toripoyo/AnalogMixer/Readme.md

# About

3Ch Analog Mixer with bluetooth in/out.

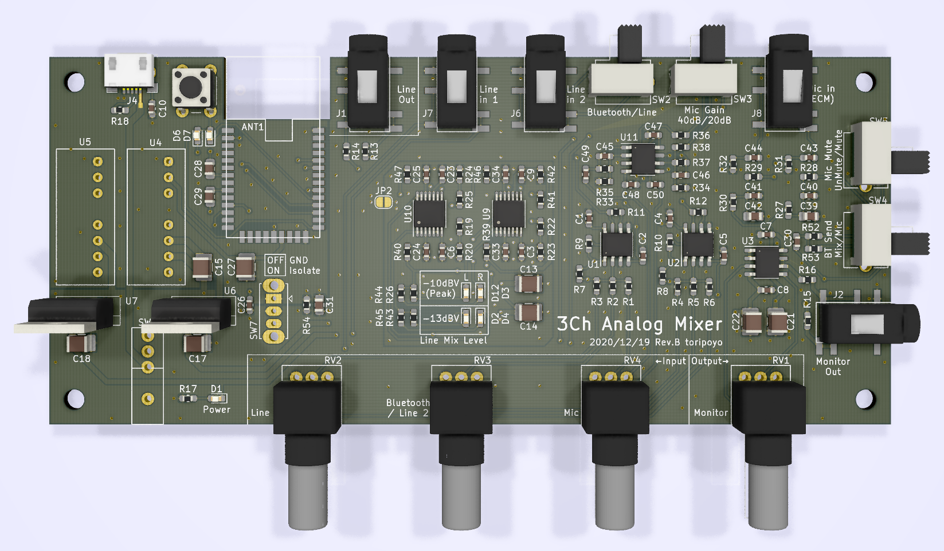
[picture p1: Board.png]
Board


## Input

- Line in 1  
- Line in 2 / Bluetooth in (Selectable)  
- Mic in  

## Output

- Monitor out (headphone)
- Line out
- Bluetooth out (Mix/Mic Selectable)

## Power

- Micro USB

## Other

- Peak warning LED (-10dBV)
