toripoyo/AnalogMixer/Mixer.pdf

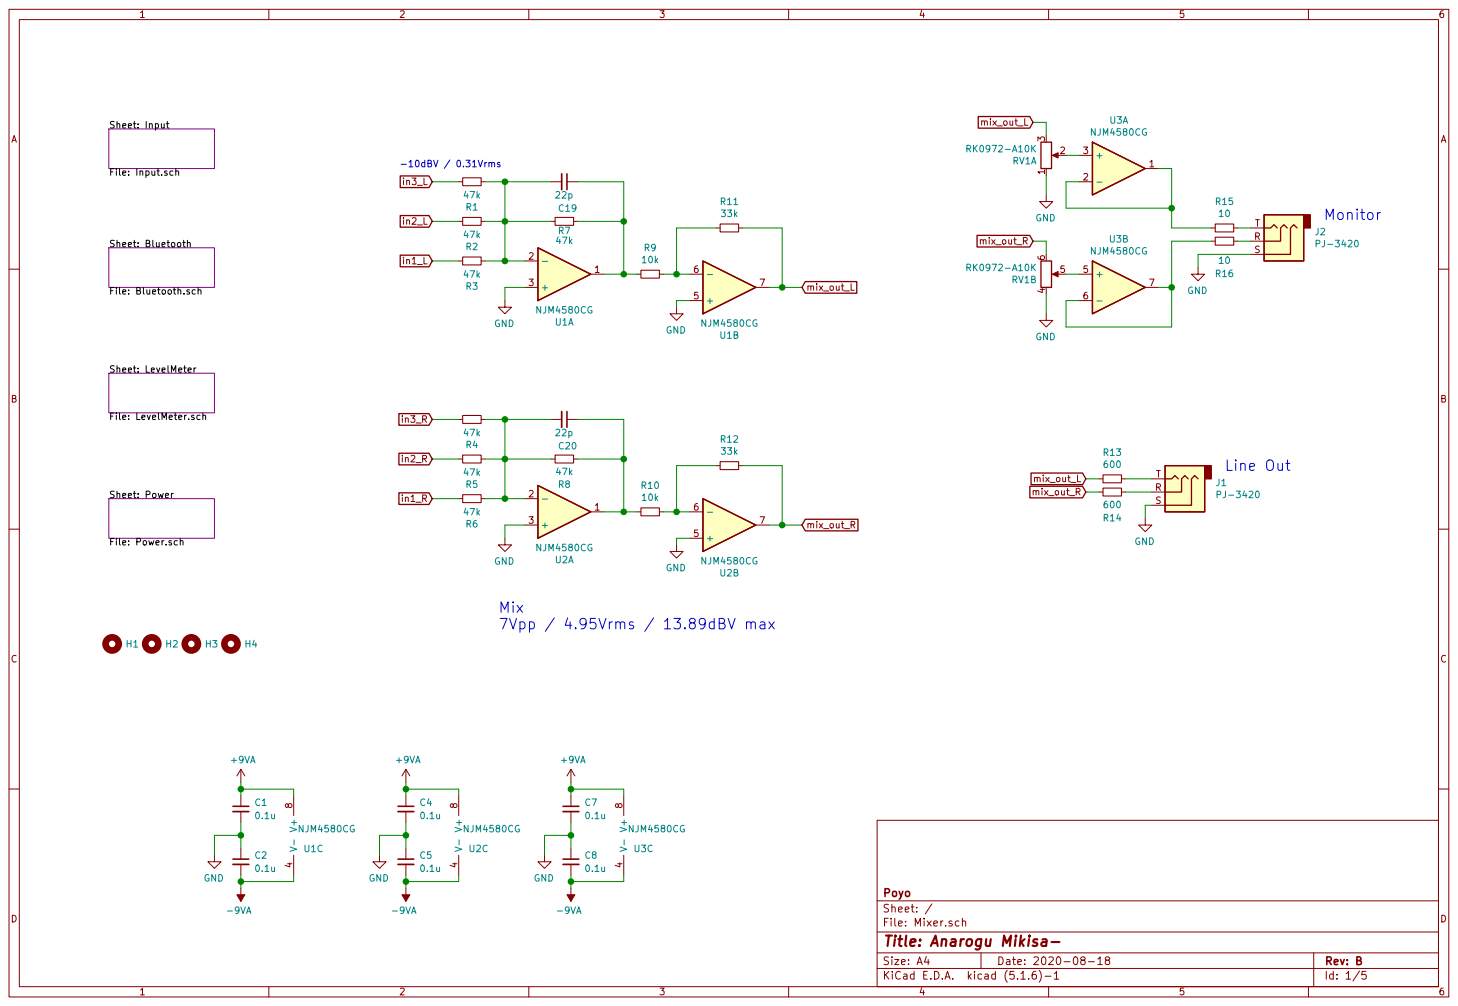
[picture p2: page 1]

Sheet: Power File: Power.sch Sheet: LevelMeter File: LevelMeter.sch Sheet: Bluetooth File: Bluetooth.sch Sheet: Input

Id: 1/5 Title: Anarogu Mikisa- File: Mixer.sch Sheet: / Poyo

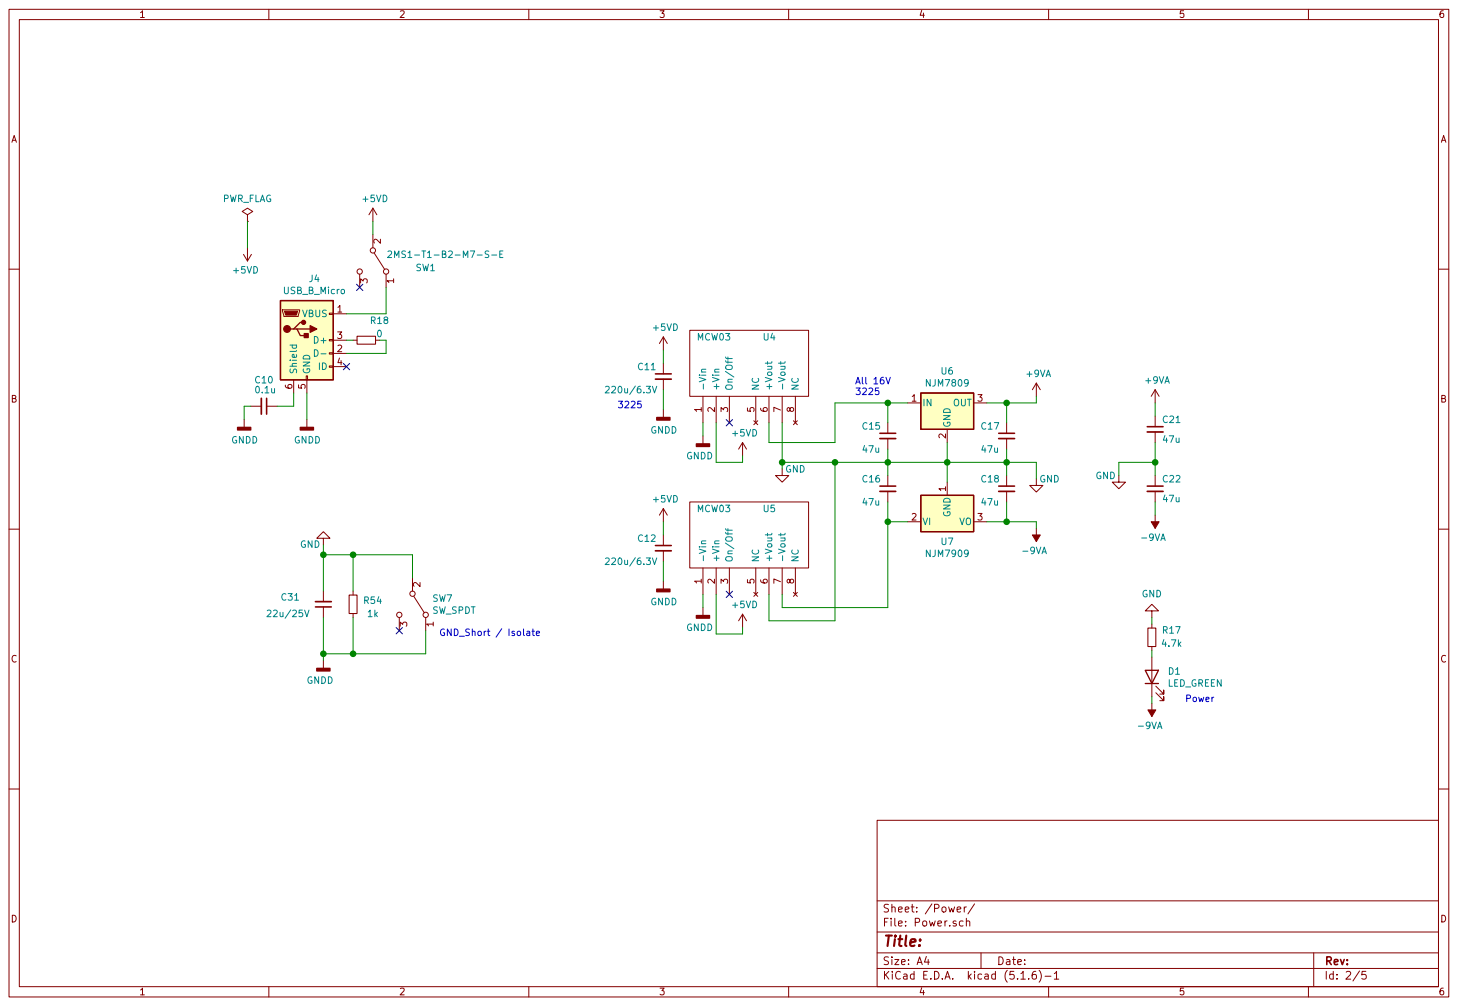
[picture p3: page 2]

Id: 2/5 Title: File: Power.sch Sheet: /Power/

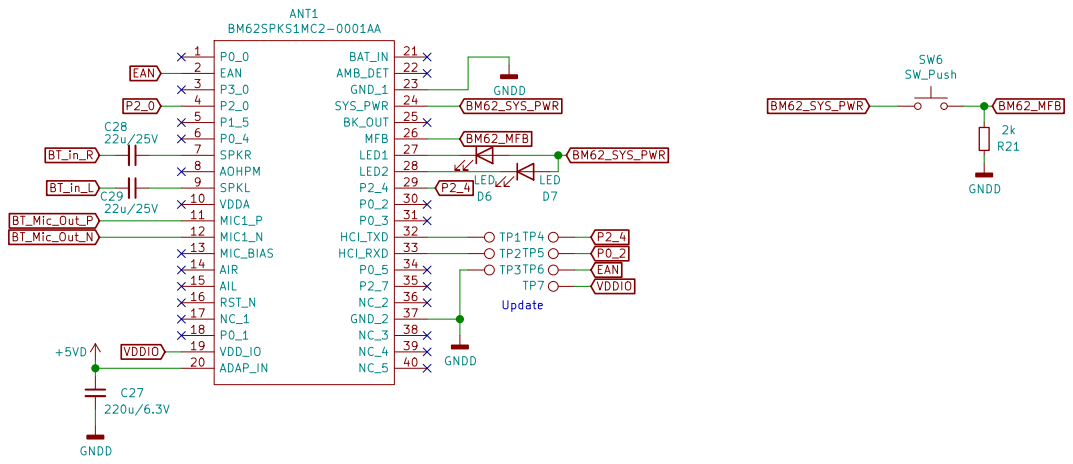
[picture p4: page 3]

Id: 3/5 Title: File: Bluetooth.sch Sheet: /Bluetooth/

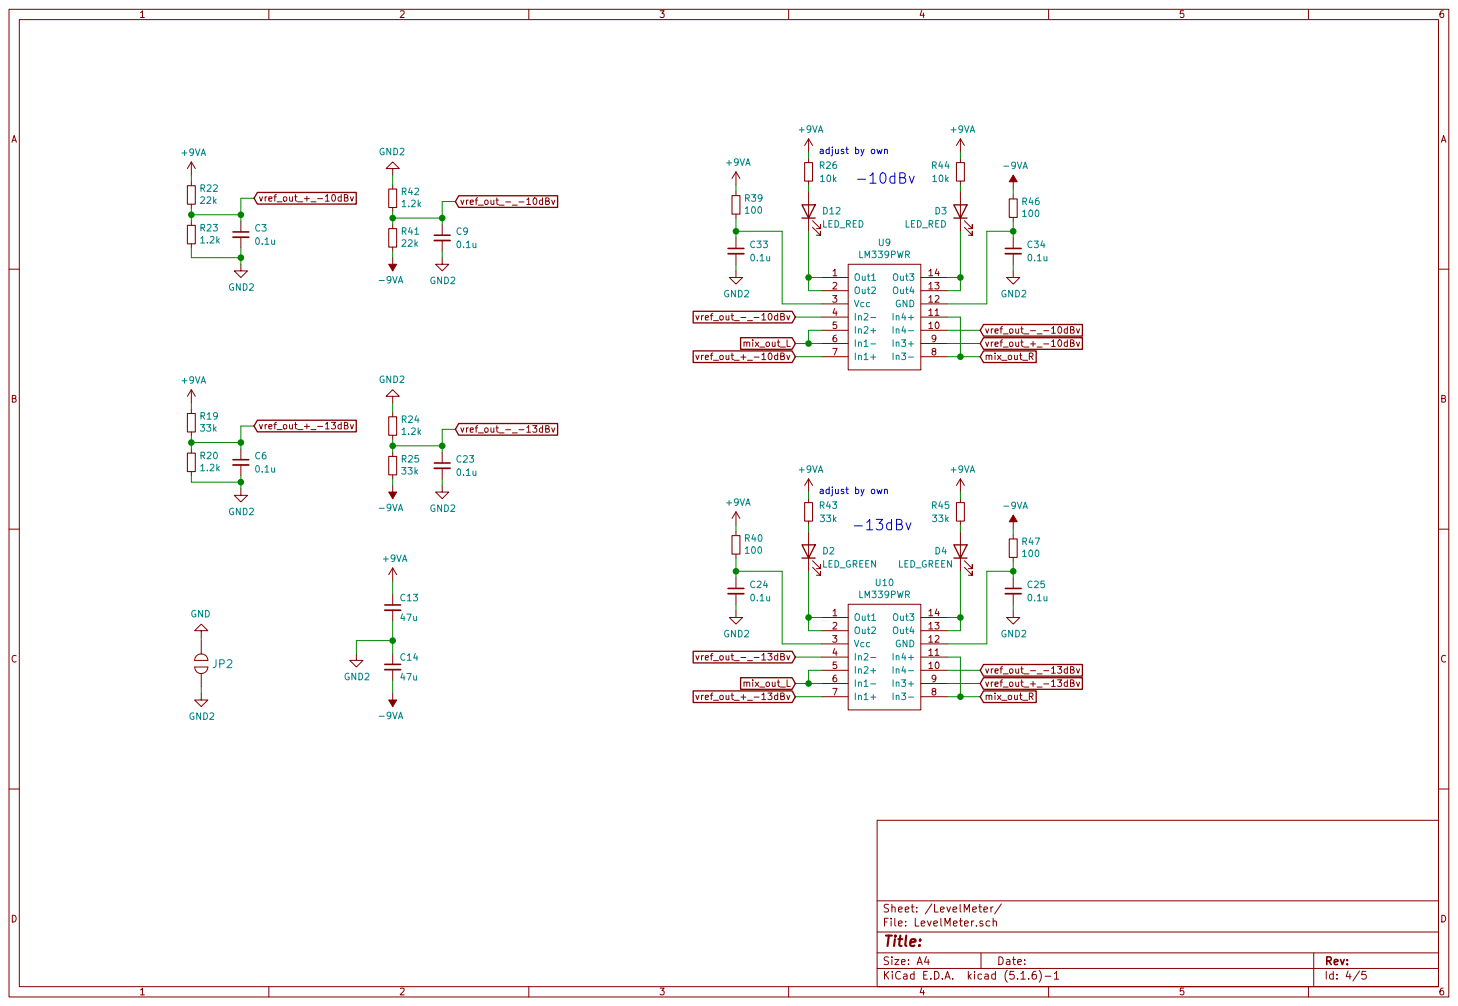
[picture p5: page 4]

Id: 4/5 Title: File: LevelMeter.sch Sheet: /LevelMeter/

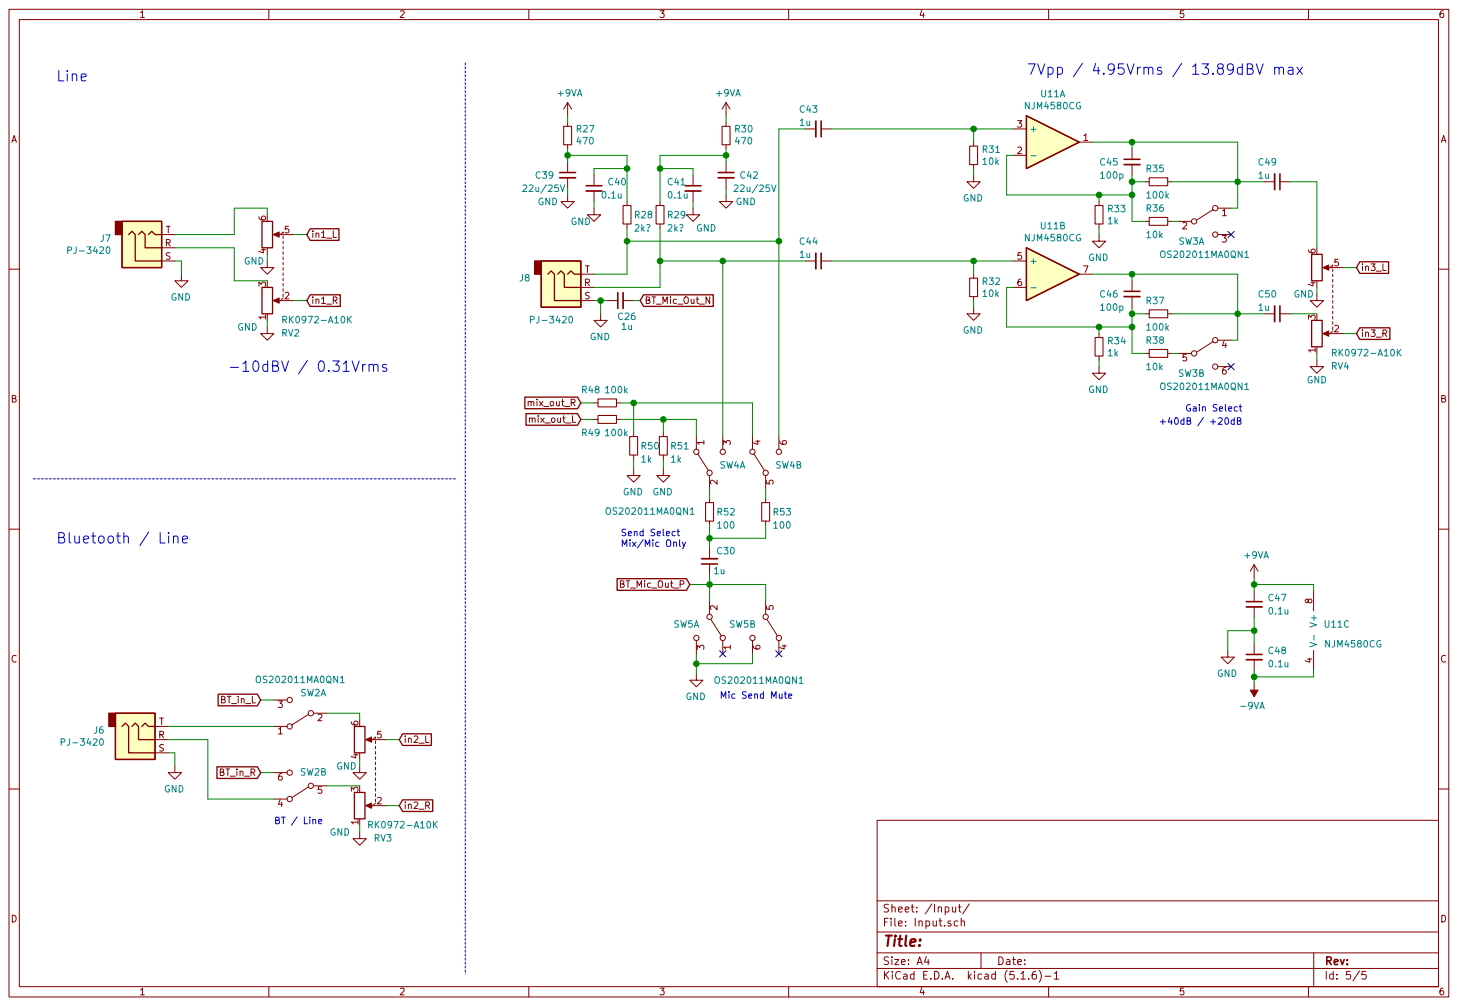
[picture p6: page 5]
