toripoyo/AnalogMixer/Mixer.kicad_pcb

## KiCad design Mixer.kicad_pcb (2020-12-19)

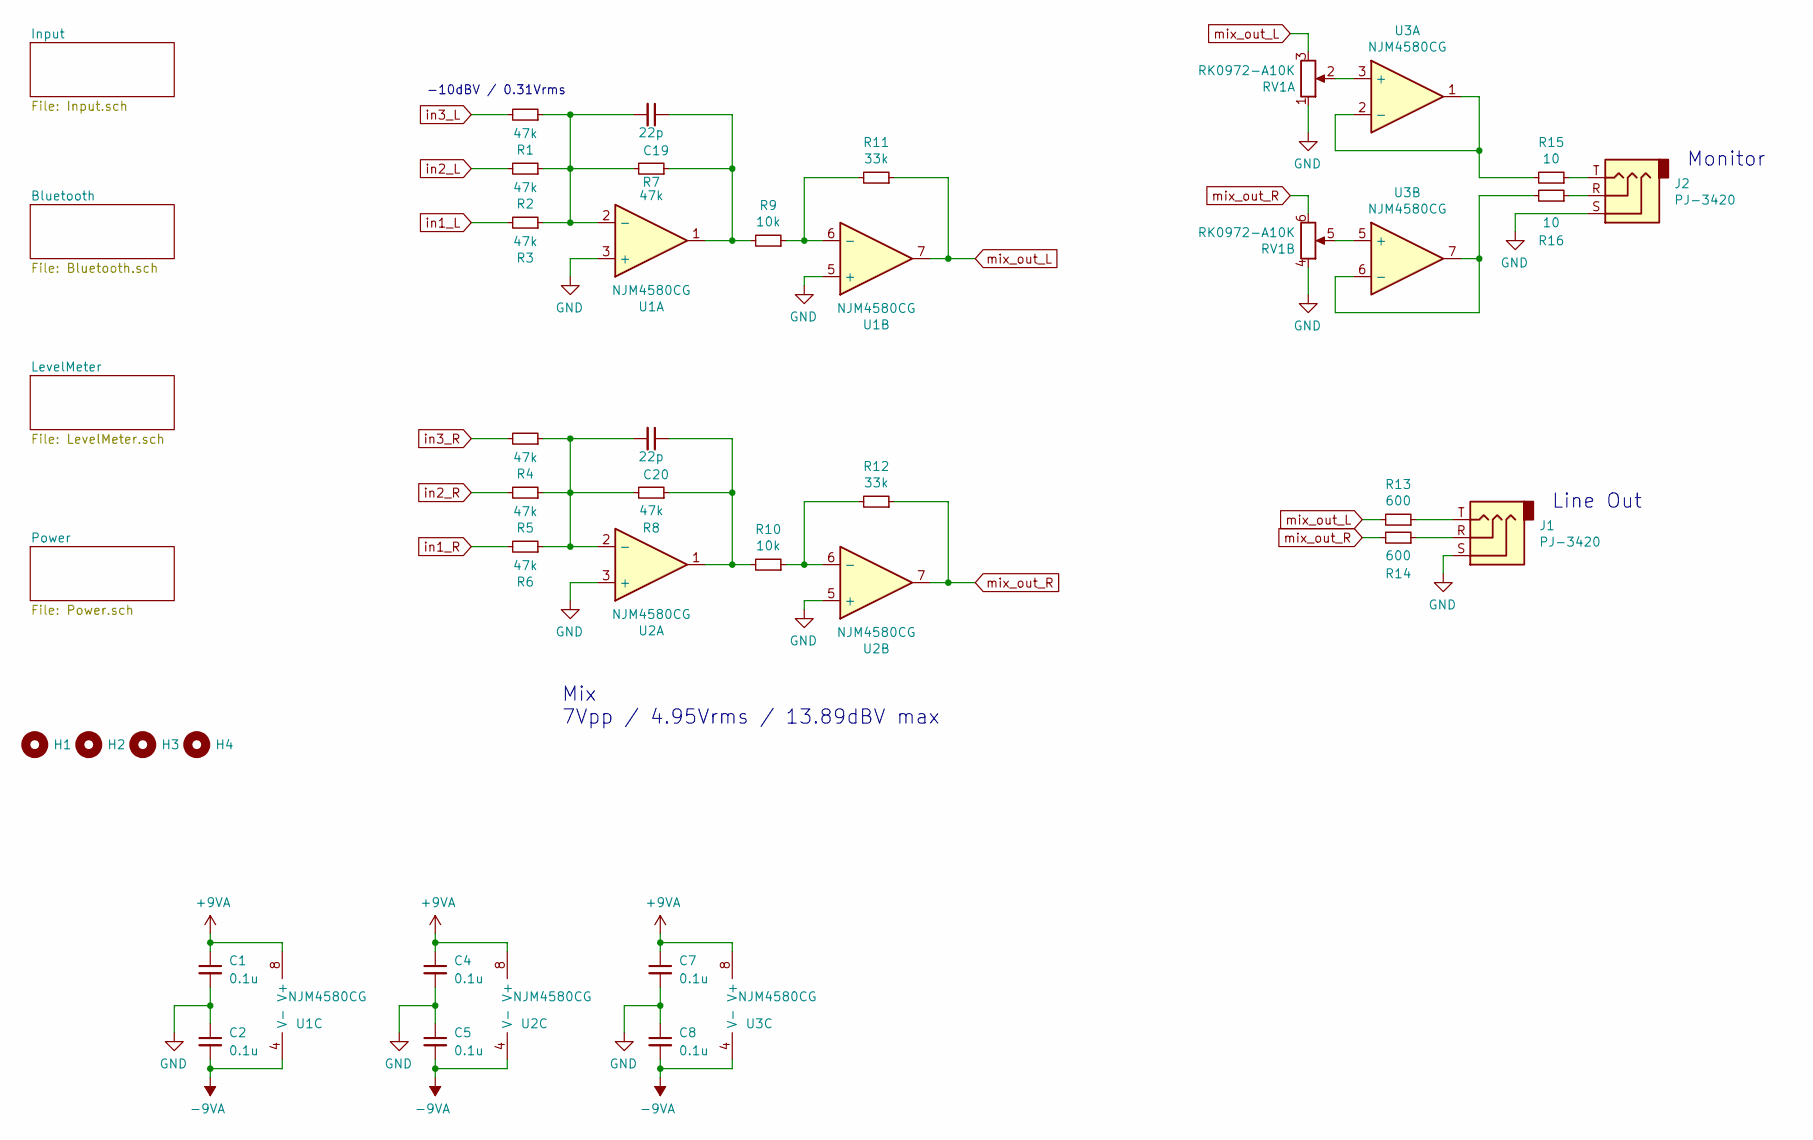
[picture p7: schematic Mixer.sch, Anarogu Mikisa-]

Parts:
C1, C2, C4, C5, C7, C8: 0.1u; C_0603_1608Metric_Pad1.05x0.95mm_HandSolder
C19, C20: 22p; C_0603_1608Metric_Pad1.05x0.95mm_HandSolder
H1, H2, H3, H4: MountingHole; MountingHole_3.2mm_M3
J1, J2: PJ-3420
R1, R2, R3, R4, R5, R6, R7, R8: 47k; R_0603_1608Metric_Pad1.05x0.95mm_HandSolder
R9, R10: 10k; R_0603_1608Metric_Pad1.05x0.95mm_HandSolder
R11, R12: 33k; R_0603_1608Metric_Pad1.05x0.95mm_HandSolder
R13, R14: 600; R_0603_1608Metric_Pad1.05x0.95mm_HandSolder
R15, R16: 10; R_0603_1608Metric_Pad1.05x0.95mm_HandSolder
RV1: RK0972-A10K; RD925G-QA1
U1, U2, U3: NJM4580CG; SOP-8_3.9x4.9mm_P1.27mm

Connections:
+9VA: C1.1, C4.1, C7.1, U1.8 (V+), U2.8 (V+), U3.8 (V+); also elsewhere on the board
-9VA: C2.2, C5.2, C8.2, U1.4 (V-), U2.4 (V-), U3.4 (V-); also elsewhere on the board
GND: C1.2, C2.1, C4.2, C5.1, C7.2, C8.1, J1.S, J2.S, RV1.1, RV1.4, U1.3 (+), U1.5 (+), U2.3 (+), U2.5 (+); also elsewhere on the board
unnamed: C19.1, R7.1, R9.2, U1.1
unnamed: C19.2, R1.1, R2.1, R3.1, R7.2, U1.2 (-)
unnamed: C20.1, R8.1, R10.2, U2.1
unnamed: C20.2, R4.1, R5.1, R6.1, R8.2, U2.2 (-)
unnamed: J1.R, R14.1
unnamed: J1.T, R13.1
unnamed: J2.R, R16.1
unnamed: J2.T, R15.1
unnamed: R10.1, R12.2, U2.6 (-)
unnamed: R9.1, R11.2, U1.6 (-)
unnamed: R15.2, U3.1, U3.2 (-)
unnamed: R16.2, U3.6 (-), U3.7
unnamed: RV1.2, U3.3 (+)
unnamed: RV1.5, U3.5 (+)
in1_L: R3.2; also elsewhere on the board
in1_R: R6.2; also elsewhere on the board
in2_L: R2.2; also elsewhere on the board
in2_R: R5.2; also elsewhere on the board
in3_L: R1.2; also elsewhere on the board
in3_R: R4.2; also elsewhere on the board
mix_out_L: R11.1, R13.2, RV1.3, U1.7; also elsewhere on the board
mix_out_R: R12.1, R14.2, RV1.6, U2.7; also elsewhere on the board

Notes on the sheet:
-10dBV / 0.31Vrms
Monitor
Line Out
Mix 7Vpp / 4.95Vrms / 13.89dBV max

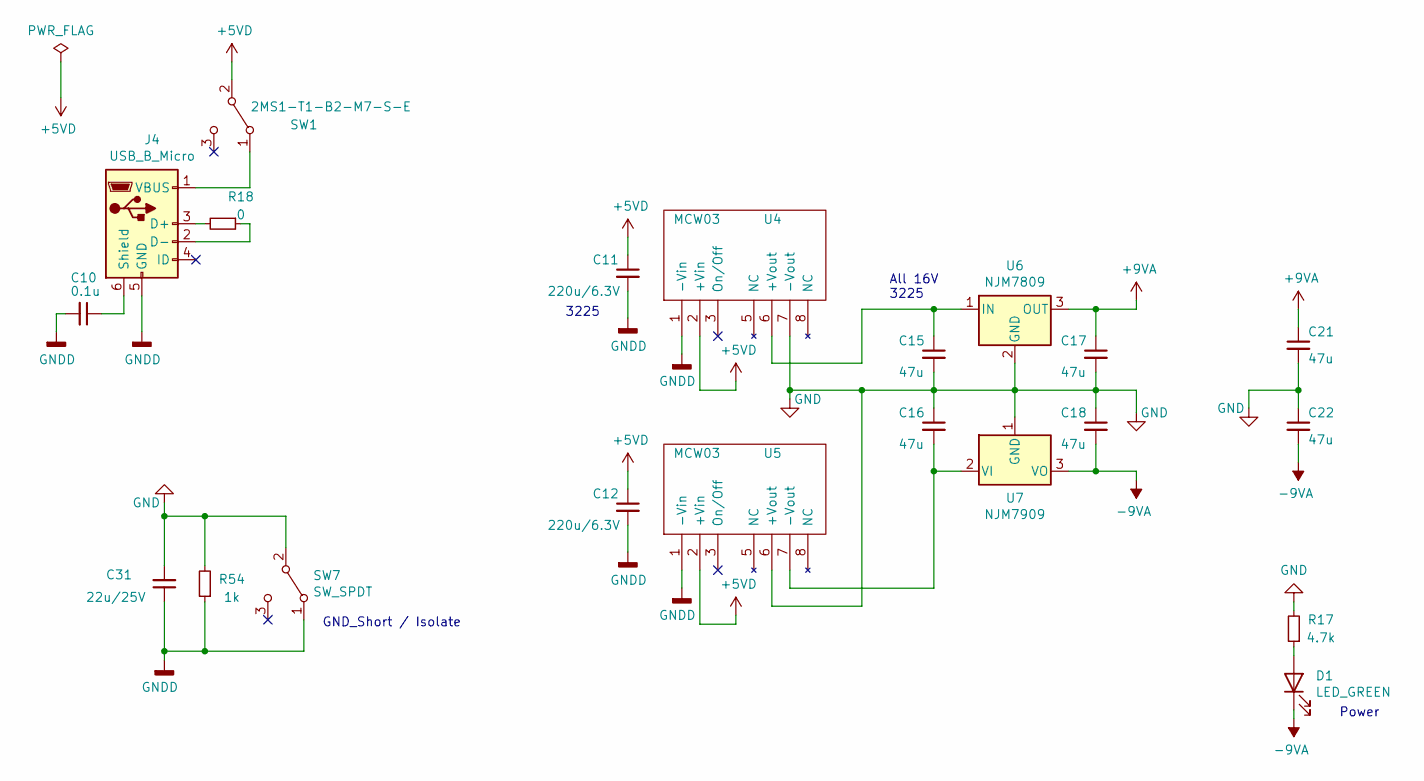
[picture p8: schematic Power.sch]

Parts:
C10: 0.1u; C_0603_1608Metric_Pad1.05x0.95mm_HandSolder
C11, C12: 220u/6.3V; C_1210_3225Metric_Pad1.42x2.65mm_HandSolder
C15, C16, C17, C18, C21, C22: 47u; C_1210_3225Metric_Pad1.42x2.65mm_HandSolder
C31: 22u/25V; C_0805_2012Metric_Pad1.15x1.40mm_HandSolder
D1: LED_GREEN; LED_0603_1608Metric_Pad1.05x0.95mm_HandSolder
J4: USB_B_Micro; USB_Micro_B_Female_10118193-0001LF
R17: 4.7k; R_0603_1608Metric_Pad1.05x0.95mm_HandSolder
R18: 0; R_0603_1608Metric_Pad1.05x0.95mm_HandSolder
R54: 1k; R_0603_1608Metric_Pad1.05x0.95mm_HandSolder
SW1: 2MS1-T1-B2-M7-S-E; T1-B2-M7-S-E
SW7: SW_SPDT; SW_Slide_1P2T_CK_OS102011MS2Q
U4, U5: MCW03
U6: NJM7809; TO-220-3_Vertical
U7: NJM7909; TO-220-3_Vertical

Connections:
+5VD: C11.1, C12.1, SW1.2 (B), U4.2 (+Vin), U5.2 (+Vin); also elsewhere on the board
+9VA: C17.1, C21.1, U6.3 (OUT); also elsewhere on the board
-9VA: C18.2, C22.2, D1.1 (K), U7.3 (VO); also elsewhere on the board
GND: C15.2, C16.1, C17.2, C18.1, C21.2, C22.1, C31.2, R17.2, R54.2, SW7.2 (B), U4.7 (-Vout), U5.6 (+Vout), U6.2 (GND), U7.1 (GND); also elsewhere on the board
GNDD: C10.2, C11.2, C12.2, C31.1, J4.5 (GND), R54.1, SW7.1 (A), U4.1 (-Vin), U5.1 (-Vin); also elsewhere on the board
unnamed: C10.1, J4.6 (Shield)
unnamed: C15.1, U4.6 (+Vout), U6.1 (IN)
unnamed: C16.2, U5.7 (-Vout), U7.2 (VI)
unnamed: D1.2 (A), R17.1
unnamed: J4.1 (VBUS), SW1.1 (A)
unnamed: J4.2 (D-), R18.1
unnamed: J4.3 (D+), R18.2

Notes on the sheet:
All 16V 3225
3225
Power
GND_Short / Isolate

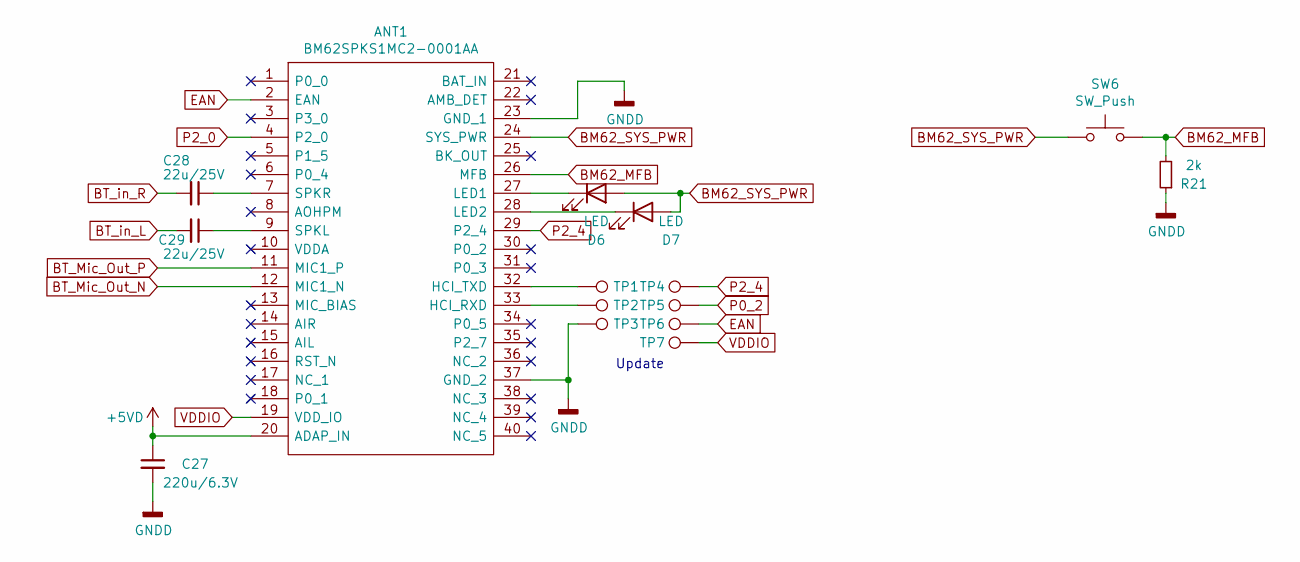
[picture p9: schematic Bluetooth.sch]

Parts:
ANT1: BM62SPKS1MC2-0001AA; BM62; Manufacturer_Part_Number BM62SPKS1MC2-0001AA; Mouser Part Number 579-62SPKS1MC20001AA
C27: 220u/6.3V; C_1210_3225Metric_Pad1.42x2.65mm_HandSolder
C28, C29: 22u/25V; C_0805_2012Metric_Pad1.15x1.40mm_HandSolder
D6, D7: LED; LED_0603_1608Metric_Pad1.05x0.95mm_HandSolder
R21: 2k; R_0603_1608Metric_Pad1.05x0.95mm_HandSolder
SW6: SW_Push; SW_PUSH_6mm
TP1, TP2, TP3, TP4, TP5, TP6, TP7: TestPoint; TestPoint_Pad_D1.0mm

Connections:
+5VD: ANT1.20 (ADAP_IN), C27.1; also elsewhere on the board
BM62_MFB: ANT1.26 (MFB), R21.2, SW6.2
BM62_SYS_PWR: ANT1.24 (SYS_PWR), D6.2 (A), D7.2 (A), SW6.1
BT_Mic_Out_N: ANT1.12 (MIC1_N); also elsewhere on the board
BT_Mic_Out_P: ANT1.11 (MIC1_P); also elsewhere on the board
BT_in_L: C29.2; also elsewhere on the board
BT_in_R: C28.2; also elsewhere on the board
EAN: ANT1.2 (EAN), TP6.1
GNDD: ANT1.23 (GND_1), ANT1.37 (GND_2), C27.2, R21.1, TP3.1; also elsewhere on the board
unnamed: ANT1.7 (SPKR), C28.1
unnamed: ANT1.9 (SPKL), C29.1
unnamed: ANT1.27 (LED1), D6.1 (K)
unnamed: ANT1.28 (LED2), D7.1 (K)
unnamed: ANT1.32 (HCI_TXD), TP1.1
unnamed: ANT1.33 (HCI_RXD), TP2.1
P2_4: ANT1.29 (P2_4), TP4.1
VDDIO: ANT1.19 (VDD_IO), TP7.1

Notes on the sheet:
Update

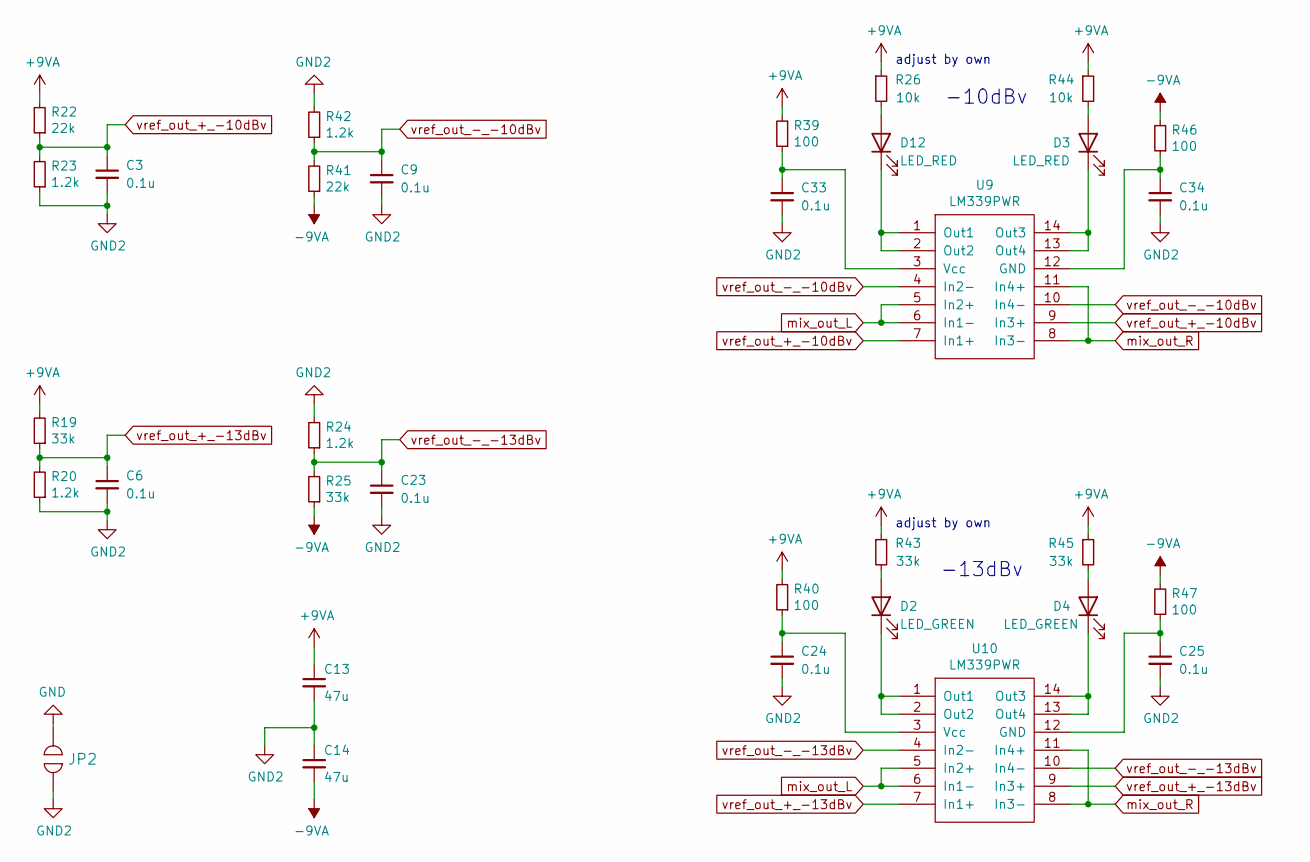
[picture p10: schematic LevelMeter.sch]

Parts:
C3, C6, C9, C23, C24, C25, C33, C34: 0.1u; C_0603_1608Metric_Pad1.05x0.95mm_HandSolder
C13, C14: 47u; C_1210_3225Metric_Pad1.42x2.65mm_HandSolder
D2, D4: LED_GREEN; LED_0603_1608Metric_Pad1.05x0.95mm_HandSolder
D3, D12: LED_RED; LED_0603_1608Metric_Pad1.05x0.95mm_HandSolder
JP2: UserShort; SolderJumper-2_P1.3mm_Open_RoundedPad1.0x1.5mm
R19, R25, R43, R45: 33k; R_0603_1608Metric_Pad1.05x0.95mm_HandSolder
R20, R23, R24, R42: 1.2k; R_0603_1608Metric_Pad1.05x0.95mm_HandSolder
R22, R41: 22k; R_0603_1608Metric_Pad1.05x0.95mm_HandSolder
R26, R44: 10k; R_0603_1608Metric_Pad1.05x0.95mm_HandSolder
R39, R40, R46, R47: 100; R_0603_1608Metric_Pad1.05x0.95mm_HandSolder
U9, U10: LM339PWR; TSSOP-14_4.4x5mm_P0.65mm

Connections:
+9VA: C13.1, R19.2, R22.2, R26.1, R39.2, R40.2, R43.1, R44.1, R45.1; also elsewhere on the board
-9VA: C14.2, R25.1, R41.1, R46.2, R47.2; also elsewhere on the board
GND: JP2.1; also elsewhere on the board
GND2: C3.2, C6.2, C9.2, C13.2, C14.1, C23.2, C24.2, C25.2, C33.2, C34.2, JP2.2, R20.1, R23.1, R24.2, R42.2
unnamed: C24.1, R40.1, U10.3 (Vcc)
unnamed: C25.1, R47.1, U10.12 (GND)
unnamed: C33.1, R39.1, U9.3 (Vcc)
unnamed: C34.1, R46.1, U9.12 (GND)
unnamed: D2.1 (K), U10.1 (Out1), U10.2 (Out2)
unnamed: D2.2 (A), R43.2
unnamed: D3.1 (K), U9.13 (Out4), U9.14 (Out3)
unnamed: D3.2 (A), R44.2
unnamed: D4.1 (K), U10.13 (Out4), U10.14 (Out3)
unnamed: D4.2 (A), R45.2
unnamed: D12.1 (K), U9.1 (Out1), U9.2 (Out2)
unnamed: D12.2 (A), R26.2
mix_out_L: U9.5 (In2+), U9.6 (In1-), U10.5 (In2+), U10.6 (In1-); also elsewhere on the board
mix_out_R: U9.8 (In3-), U9.11 (In4+), U10.8 (In3-), U10.11 (In4+); also elsewhere on the board
vref_out_+_-10dBv: C3.1, R22.1, R23.2, U9.7 (In1+), U9.9 (In3+)
vref_out_+_-13dBv: C6.1, R19.1, R20.2, U10.7 (In1+), U10.9 (In3+)
vref_out_-_-10dBv: C9.1, R41.2, R42.1, U9.4 (In2-), U9.10 (In4-)
vref_out_-_-13dBv: C23.1, R24.1, R25.2, U10.4 (In2-), U10.10 (In4-)

Notes on the sheet:
-10dBv
-13dBv
adjust by own

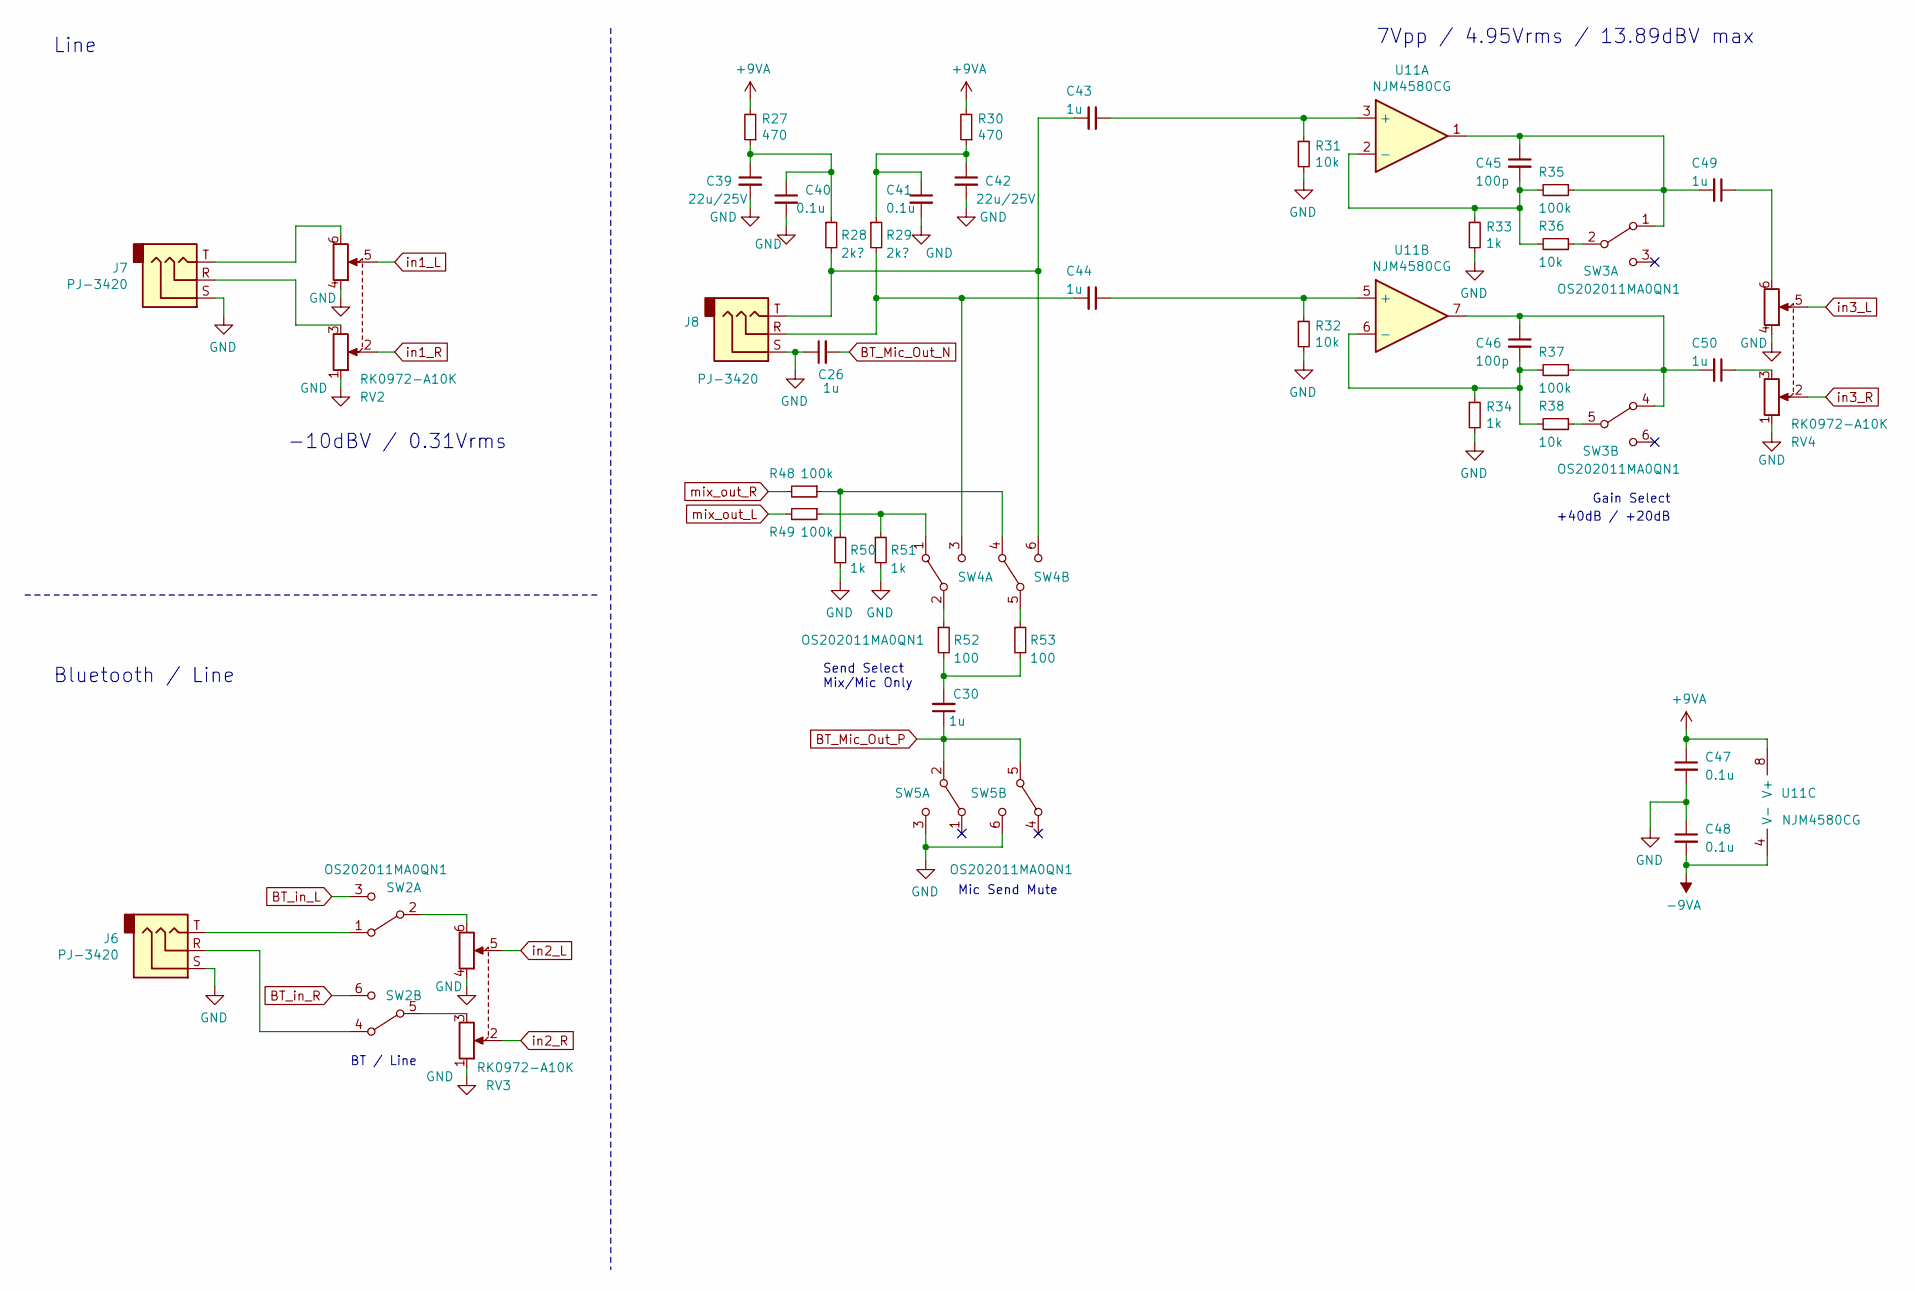
[picture p11: schematic Input.sch]

Parts:
C26, C30, C43, C44, C49, C50: 1u; C_0603_1608Metric_Pad1.05x0.95mm_HandSolder
C39, C42: 22u/25V; C_0805_2012Metric_Pad1.15x1.40mm_HandSolder
C40, C41, C47, C48: 0.1u; C_0603_1608Metric_Pad1.05x0.95mm_HandSolder
C45, C46: 100p; C_0603_1608Metric_Pad1.05x0.95mm_HandSolder
J6, J7, J8: PJ-3420
R27, R30: 470; R_0603_1608Metric_Pad1.05x0.95mm_HandSolder
R28, R29: 2k?; R_0603_1608Metric_Pad1.05x0.95mm_HandSolder
R31, R32, R36, R38: 10k; R_0603_1608Metric_Pad1.05x0.95mm_HandSolder
R33, R34, R50, R51: 1k; R_0603_1608Metric_Pad1.05x0.95mm_HandSolder
R35, R37, R48, R49: 100k; R_0603_1608Metric_Pad1.05x0.95mm_HandSolder
R52, R53: 100; R_0603_1608Metric_Pad1.05x0.95mm_HandSolder
RV2, RV3, RV4: RK0972-A10K; RD925G-QA1
SW2, SW3, SW4, SW5: OS202011MA0QN1
U11: NJM4580CG; SOP-8_3.9x4.9mm_P1.27mm

Connections:
+9VA: C47.1, R27.2, R30.2, U11.8 (V+); also elsewhere on the board
-9VA: C48.2, U11.4 (V-); also elsewhere on the board
BT_Mic_Out_N: C26.2; also elsewhere on the board
BT_Mic_Out_P: C30.1, SW5.2 (B), SW5.5 (B); also elsewhere on the board
BT_in_L: SW2.3 (C); also elsewhere on the board
BT_in_R: SW2.6 (C); also elsewhere on the board
GND: C26.1, C39.2, C40.2, C41.2, C42.2, C47.2, C48.1, J6.S, J7.S, J8.S, R31.2, R32.2, R33.2, R34.2, R50.2, R51.2, RV2.1, RV2.4, RV3.1, RV3.4, RV4.1, RV4.4, SW5.3 (C), SW5.6 (C); also elsewhere on the board
unnamed: C30.2, R52.2, R53.2
unnamed: C39.1, C40.1, R27.1, R28.1
unnamed: C41.1, C42.1, R29.1, R30.1
unnamed: C43.1, R31.1, U11.3 (+)
unnamed: C43.2, J8.T, R28.2, SW4.6 (C)
unnamed: C44.1, R32.1, U11.5 (+)
unnamed: C44.2, J8.R, R29.2, SW4.3 (C)
unnamed: C45.1, C49.2, R35.1, SW3.1 (A), U11.1
unnamed: C45.2, R33.1, R35.2, R36.2, U11.2 (-)
unnamed: C46.1, C50.2, R37.1, SW3.4 (A), U11.7
unnamed: C46.2, R34.1, R37.2, R38.2, U11.6 (-)
unnamed: C49.1, RV4.6
unnamed: C50.1, RV4.3
unnamed: J6.R, SW2.4 (A)
unnamed: J6.T, SW2.1 (A)
unnamed: J7.R, RV2.3
unnamed: J7.T, RV2.6
unnamed: R36.1, SW3.2 (B)
unnamed: R38.1, SW3.5 (B)
unnamed: R48.1, R50.1, SW4.4 (A)
unnamed: R49.1, R51.1, SW4.1 (A)
unnamed: R52.1, SW4.2 (B)
unnamed: R53.1, SW4.5 (B)
unnamed: RV3.3, SW2.5 (B)
unnamed: RV3.6, SW2.2 (B)
in1_L: RV2.5; also elsewhere on the board
in1_R: RV2.2; also elsewhere on the board
in2_L: RV3.5; also elsewhere on the board
in2_R: RV3.2; also elsewhere on the board
in3_L: RV4.5; also elsewhere on the board
in3_R: RV4.2; also elsewhere on the board
mix_out_L: R49.2; also elsewhere on the board
mix_out_R: R48.2; also elsewhere on the board

Notes on the sheet:
+40dB / +20dB
-10dBV / 0.31Vrms
7Vpp / 4.95Vrms / 13.89dBV max
Bluetooth / Line
BT / Line
Line
Gain Select
Send Select Mix/Mic Only
Mic Send Mute

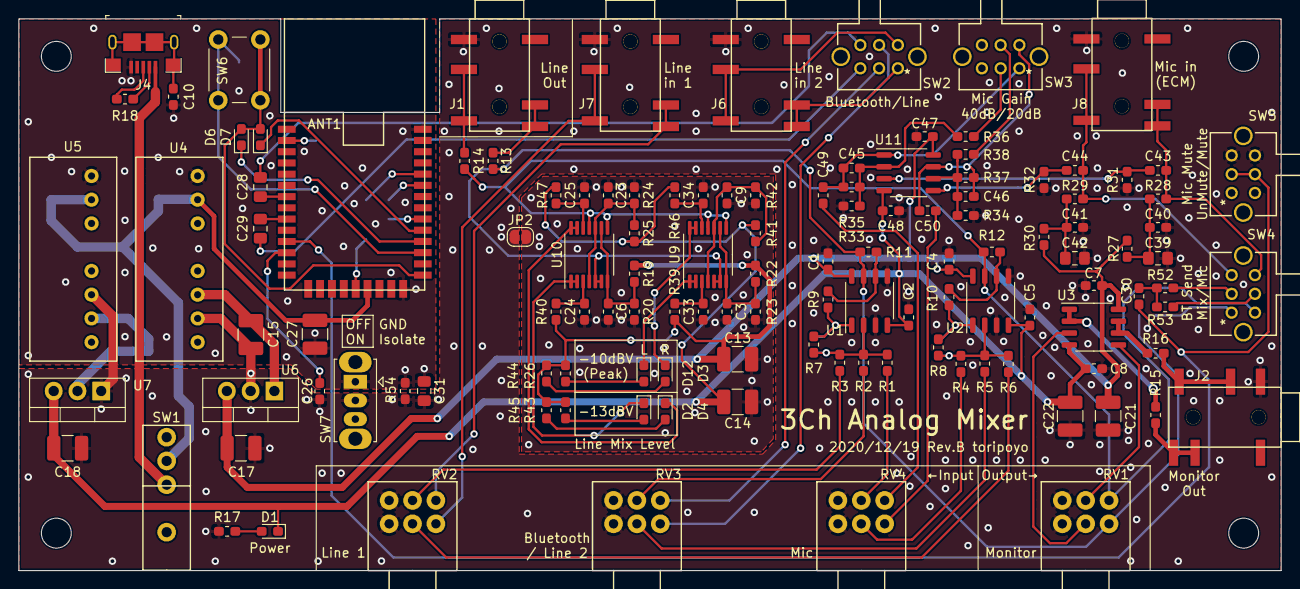
[picture p12: board Mixer.kicad_pcb from above]

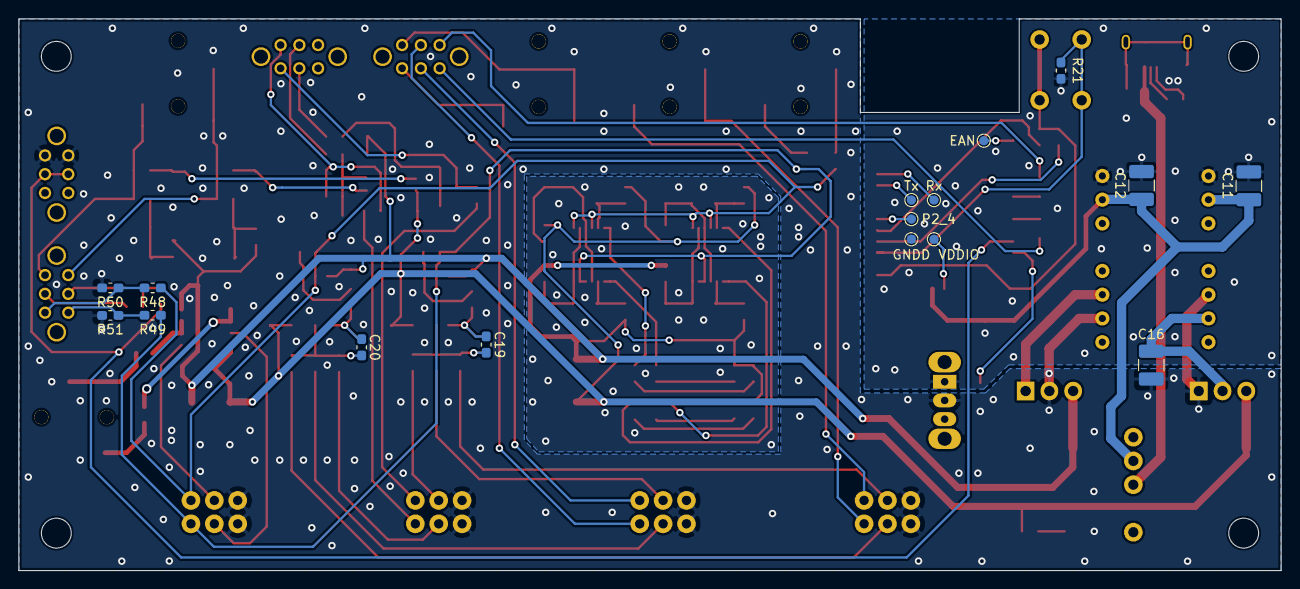
[picture p13: board Mixer.kicad_pcb from below]

Board: 2 copper layers, 135.0 x 59.0 mm, 145 parts (16 on the bottom side), 91 nets.
