toripoyo/AnalogMixer/(threads)

Thread 2 (2020-07-06):

その他

toripoyo, 2020-07-06:
* コンデンサマイクのゲイン切り替えスイッチ 切り替え時にゲイン無限になる可能性があるので、並列で抵抗値減らすスイッチにしたほうが良い
* あと40dB一段で稼ぐと発振する可能性高いので位相補償つけたほうがいい
* メーター LR両方信号ありのときと片CHだけ信号ありのときにつく閾値が6dB違くなるので、レベルメーターをLRで分けるか、LRのORで点灯させるようにしたほうがいい （編集済み）
* BTモジュール Input protection これだとディストーションになりそうだけど入力レベルそんなに小さい？
max1Vppくらいならミキサーアウトからアッテネートする必要がありそう

* BTからの入力にボリュームなくて大丈夫？
* ラインアウトボリュームなしはしんどそう ヘッドホンかBTのアウトと同じにしたほうがいいかも
* モニター出力 発振防止に出力に直列に10Ωくらいつけておいたほうがいい
* マイクはミュートボタンあったほうが便利かも （編集済み）

* アナログのレール電圧に同じDCDC使うとスイッチングのビートノイズが影響出そう
別のDCDCとかにしてスイッチング周波数が20kHz以上離れてれば問題ないと思う それか同期

Closed 2020-07-24.
