toripoyo/AnalogMixer/(commit log)

2020-07-24 Add Readme and schematic pdf.
    [部品表.xlsx]
2020-08-24 Rev.A 作成中
    [Bluetooth.sch, Input.sch, LevelMeter.sch, Mixer.kicad_pcb, Mixer.sch, Power.sch]
2020-11-24 Rev.A 完成
    [Bluetooth.sch, Input.sch, LevelMeter.sch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]
2020-11-24 Add B.Cu gbr
    [Mixer-B_Cu.gbl, Mixer-B_Mask.gbs, Mixer-B_SilkS.gbo, Mixer-Edge_Cuts.gm1, Mixer-F_Cu.gtl, Mixer-F_Mask.gts, Mixer-F_SilkS.gto, Mixer.drl]
2020-11-24 Add Schematic pdf
2020-11-24 Fix Gerber Bug
    [Mixer-B_Cu.gbl, Mixer-B_Mask.gbs, Mixer-B_SilkS.gbo, Mixer-Edge_Cuts.gm1, Mixer-F_Cu.gtl, Mixer-F_Mask.gts, Mixer-F_SilkS.gto, Mixer.drl]
2020-12-19 Rev.B 改版完了
    [Bluetooth.sch, Input.sch, LevelMeter.sch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]
2020-12-19 シルク修正
    [Mixer.kicad_pcb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]
